yz88/arduino-digital-carb-sync/part1/README.md

# part 1 - arduino-free-running-analog-read

Part 1 covers fast reading of analog values. The values are raw values without smoothing.

## bill of material

* Arduino Uno
* Analog Pressure Sensors (MPX4115AP)
* Capacitors 1µF and 100nF

## schematic

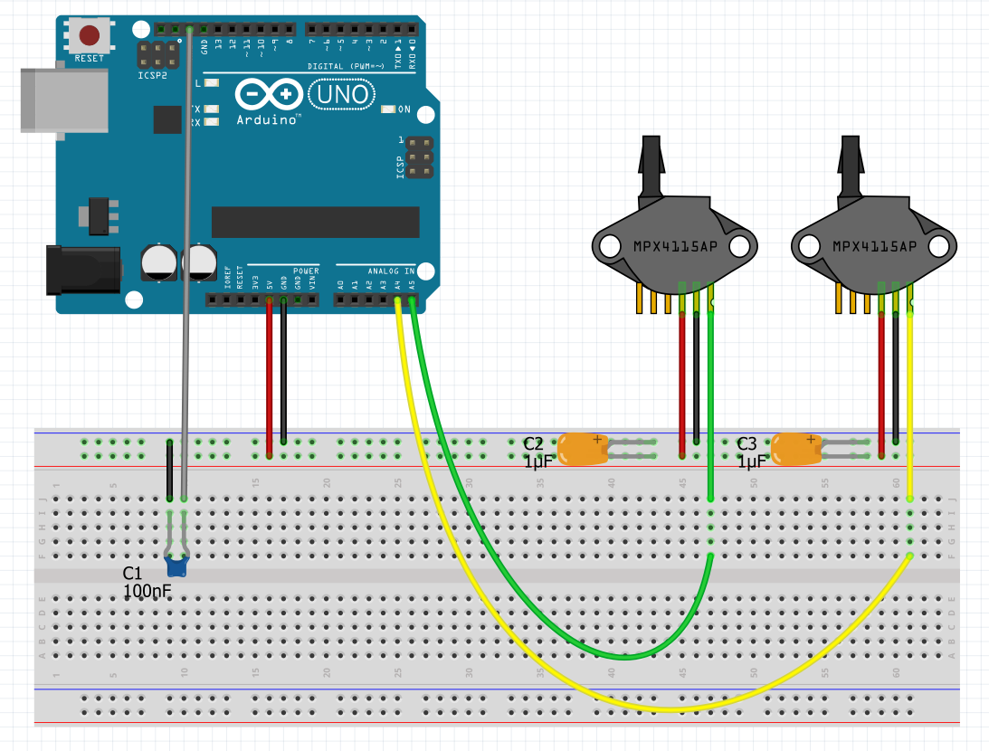
[picture p2: part1/arduino-carb-sync-part1-001.PNG]
Fritzing


## serial plot

The following graph shows the measurement curves of the two pressure sensors. The blue line shows the first pressure sensor (right cylinder), the red line the second (left cylinder).

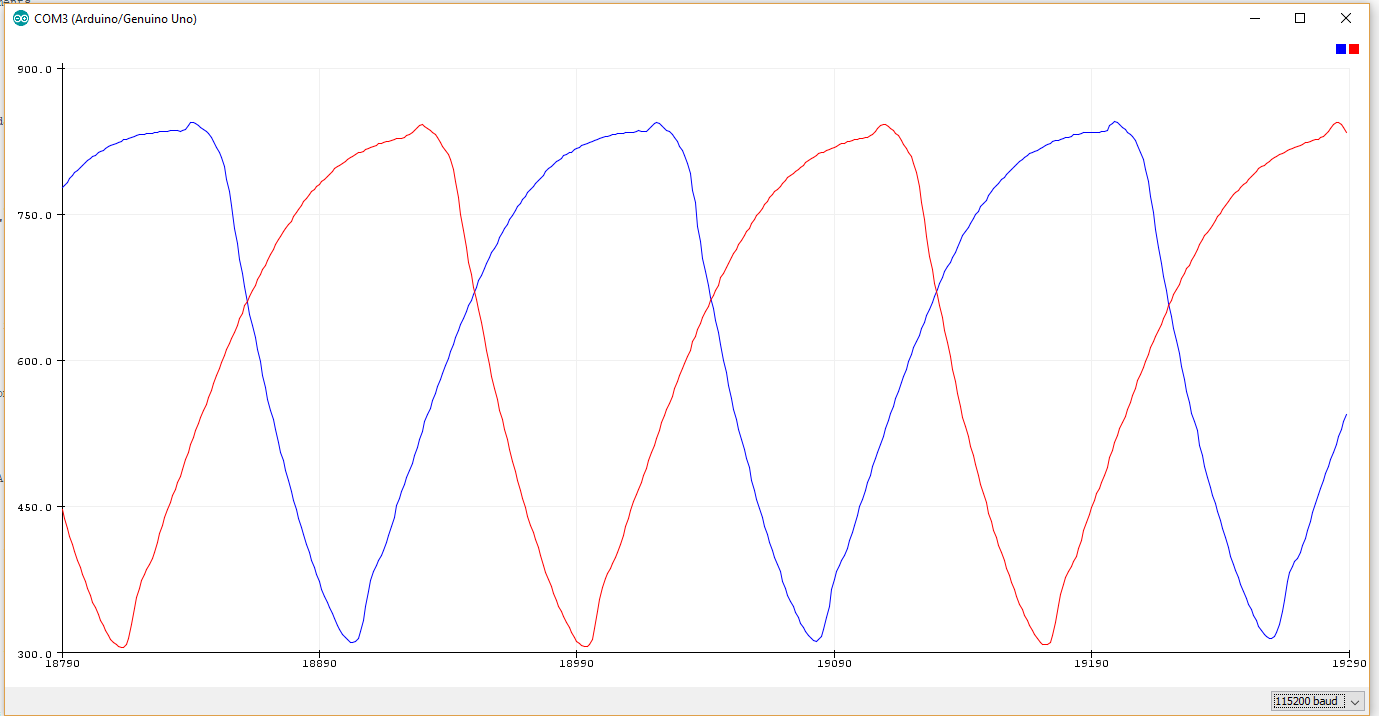
[picture p3: part1/serial-plot-part1.PNG]
Serial Plot
