yz88/arduino-digital-carb-sync/part2/README.md

# part 2 - arduino-free-running-analog-read

Part 2 covers fast reading and smoothing of analog values. Additionally the min values are determined.

## bill of material

* Arduino Uno
* Analog Pressure Sensors (MPX4115AP)
* Capacitors 1µF and 100nF

## schematic

Fritzing

## serial plot

The following graph shows the measurement curves of the two pressure sensors. The blue line shows the first pressure sensor (right cylinder), the grenn line the second (left cylinder). The orange an red line depics the minimum values from each cylinder.

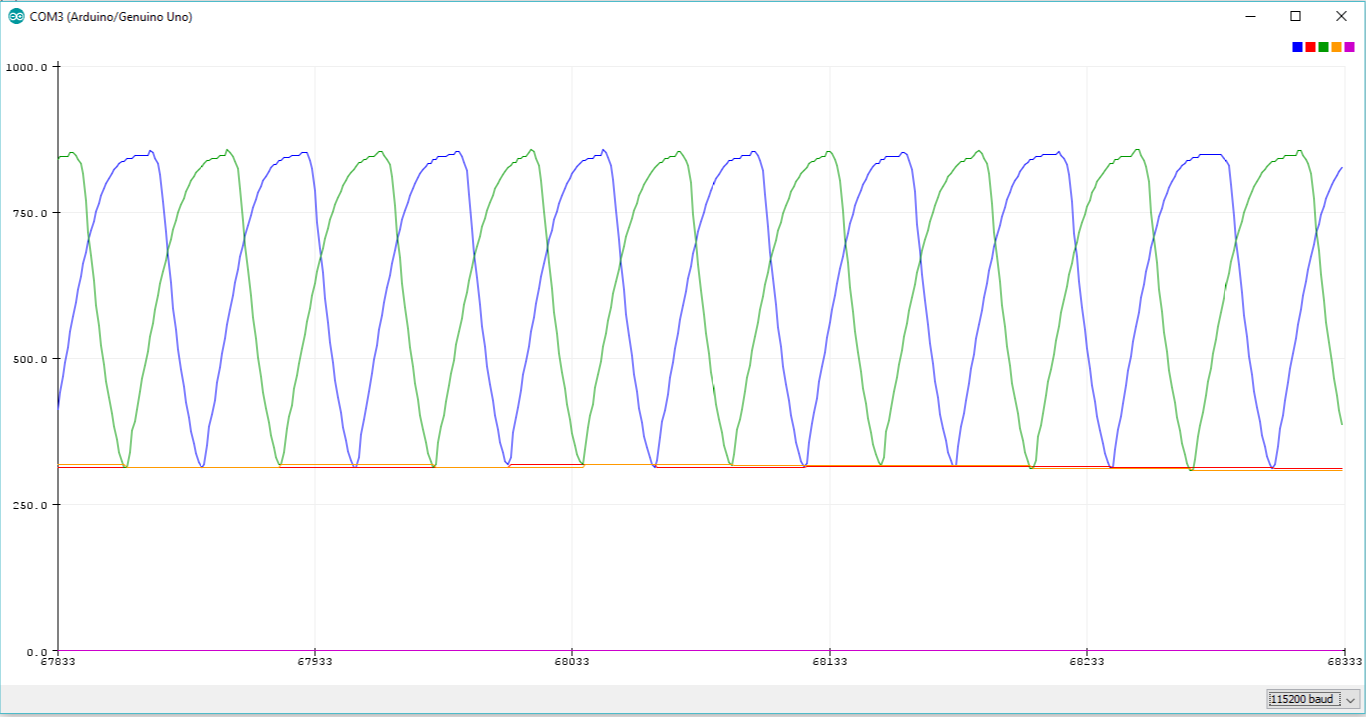
[picture p4: part2/serial-plot-part2.PNG]
Serial Plot


If the orange and red lines are on top of each other, then the carburettors run synchronously.
