yz88/arduino-digital-carb-sync/part3/README.md

# arduino-nextion-serial-communication

Part 3 covers the serial communication between the Arduino an the Nextion display without using the Nextion library.

## bill of material

* Arduino Uno
* Analog Pressure Sensors (MPX4115AP)
* Capacitors 1µF and 100nF
* Nextion NX3224T024_011R

## schematic

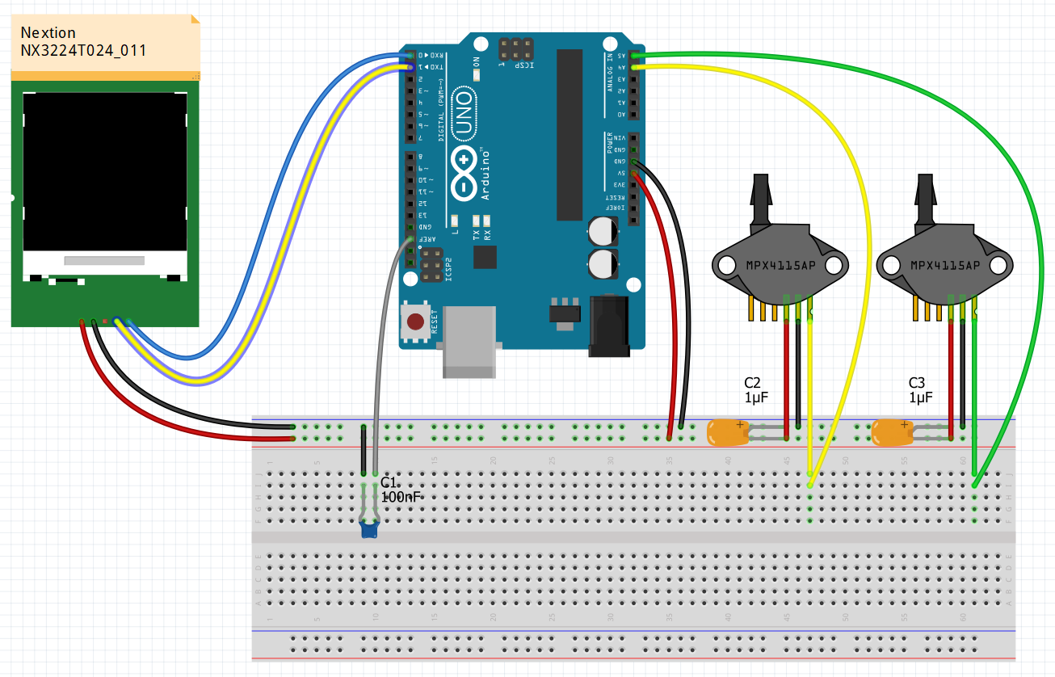
[picture p5: part3/arduino-carb-sync-part3-001.PNG]


## Nextion layout

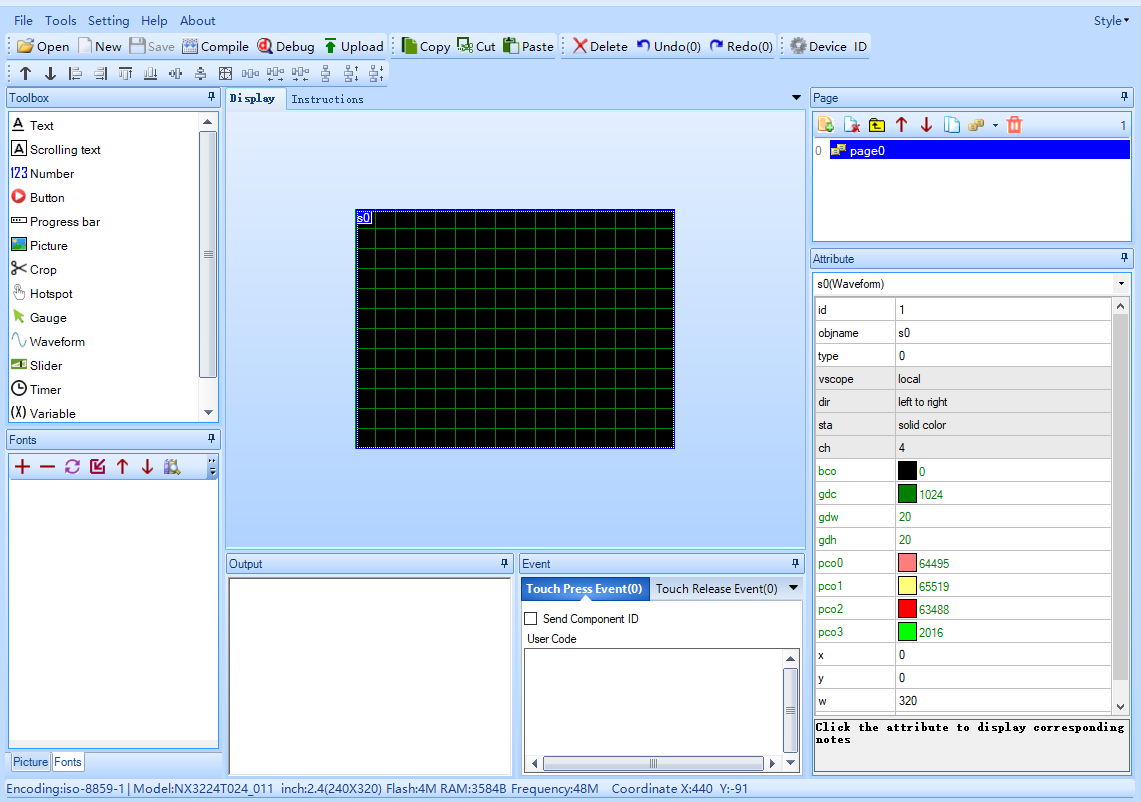
[picture p6: part3/arduino-carb-sync-part3-002.PNG]
