yz88/arduino-digital-carb-sync/part4/README.md

# arduino-nextion-serial-communictaion

Part 4 puts all other parts togehter.

* freeruning analog read
* smoothing the values
* direct serial communication between Arduino and Nextion Display
  * using Nextion waveform

## bill of material

* Arduino Uno
* Analog Pressure Sensors (MPX4115AP)
* Capacitors 1µF and 100nF
* Nextion NX3224T024_011R

## schematic

Fritzing

## Nextion layout

Nextion Editor
