yz88/arduino-digital-carb-sync/part5/README.md

# arduino-nextion-serial-communictaion

Part 5 uses Nextion's progressbar instead of waveform. 

* freeruning analog read
* smoothing the values
* direct serial communication between Arduino and Nextion Display
  * using Nextion progressbar

## bill of material

* Arduino Uno
* Analog Pressure Sensors (MPX4115AP)
* Capacitors 1µF and 100nF
* Nextion NX3224T024_011R

## schematic

Fritzing

## Nextion layout

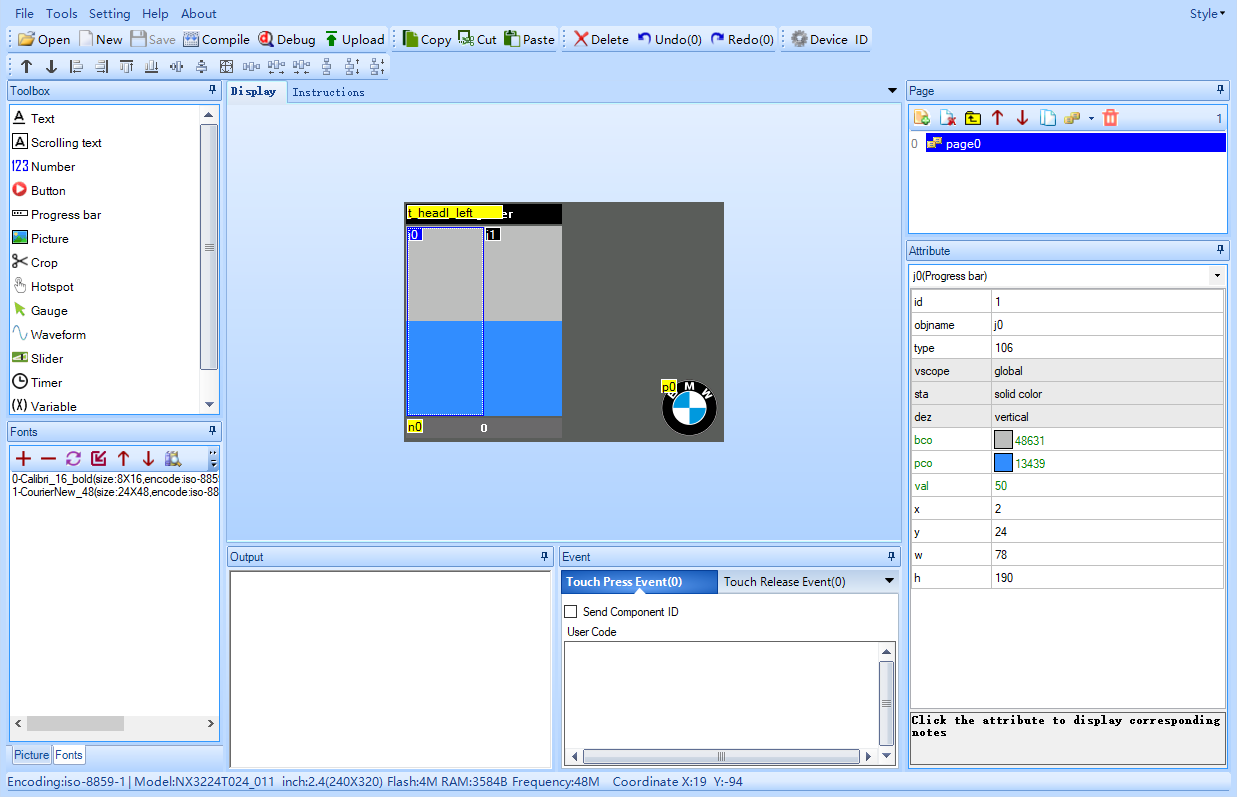
[picture p7: part5/arduino-carb-sync-part5-002.PNG]
Nextion Editor


## Demo video

https://youtu.be/DKk2O86xgPw
