yz88/arduino-digital-carb-sync/part6/README.md

# arduino-nextion-serial-communictaion

Part 6 is a spezial version that displays the pressure as well as the battery voltage from a LiFePo4 (4s2p) motorcycle battery

* freeruning analog read
* smoothing the values
* direct serial communication between Arduino and Nextion Display
  * using Nextion progressbar

## status

WORK IN PROGRESS

## bill of material

* Arduino Uno
* Analog Pressure Sensors (MPX4115AP)
* Capacitors 1µF and 100nF
* Nextion NX3224T024_011R
* LiFePo4 motorcycle battery with balancer connector

## schematic

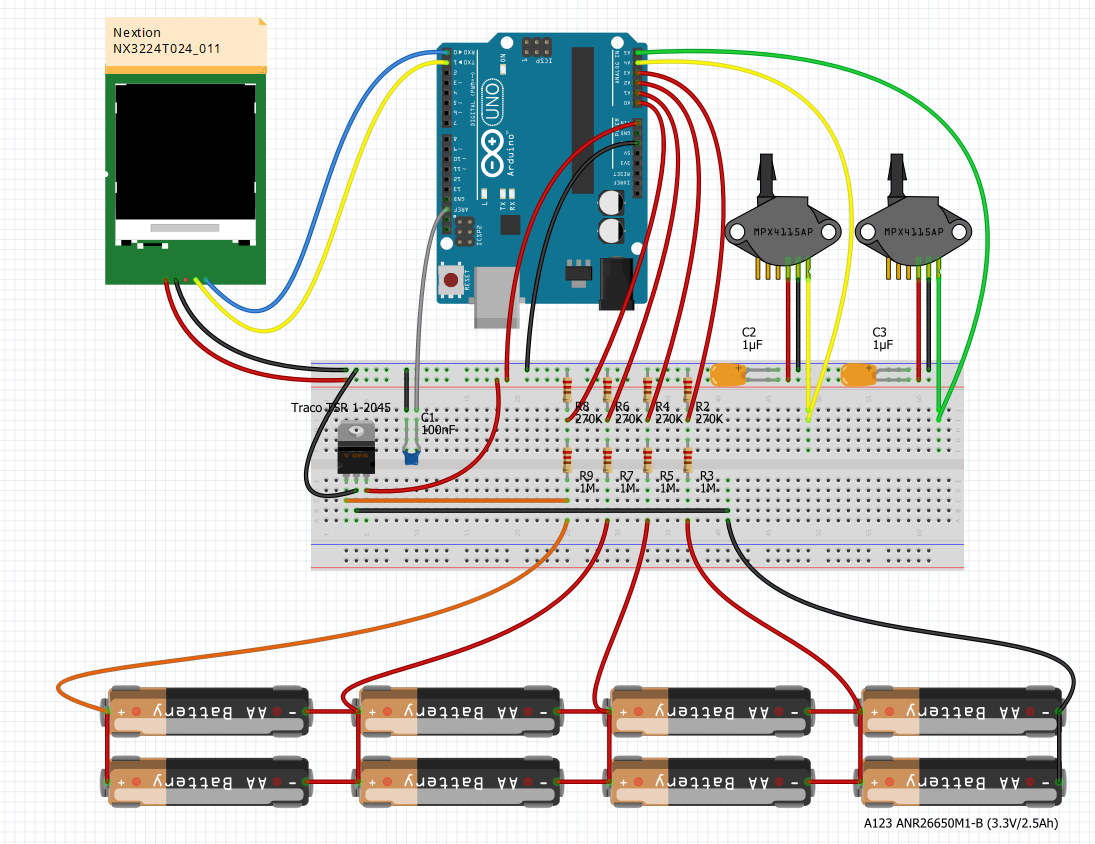
[picture p8: part6/arduino-carb-sync-part6-001.PNG]
Fritzing


## Nextion layout

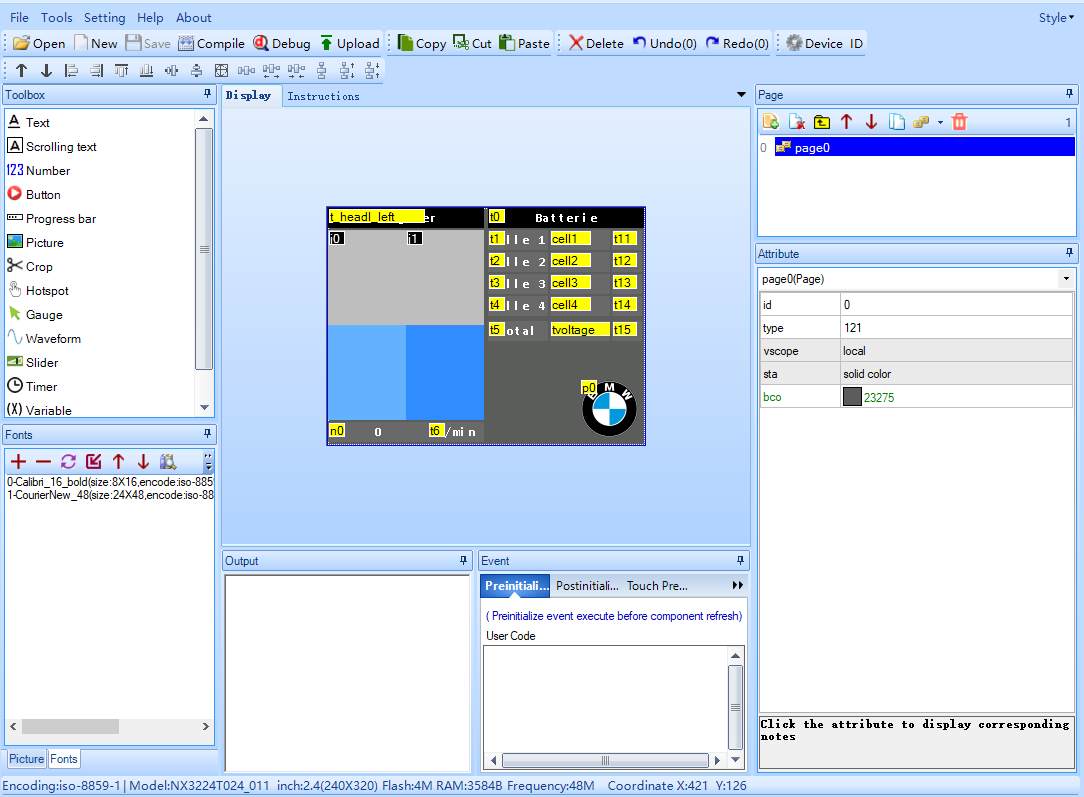
[picture p9: part6/arduino-carb-sync-part6-002.PNG]
Nextion Editor
