yz88/arduino-digital-carb-sync/part1/example-4-sensors/README.md

# part 1 - arduino-free-running-analog-read (extended)

With this extended code of part 1 the Arduino Uno reads 4 sensors (analog pin ADC0 to ADC3)
