yz88/arduino-digital-carb-sync/(commit log)

2018-10-11 Create analogRead-free-runnig-v1r1.ino
    add sensor calibration during setup
2020-06-01 add example fpr 4 sensors
2020-06-01 added example for 4 sensors
